cr1tbit/cyberlamp/outline.dxf

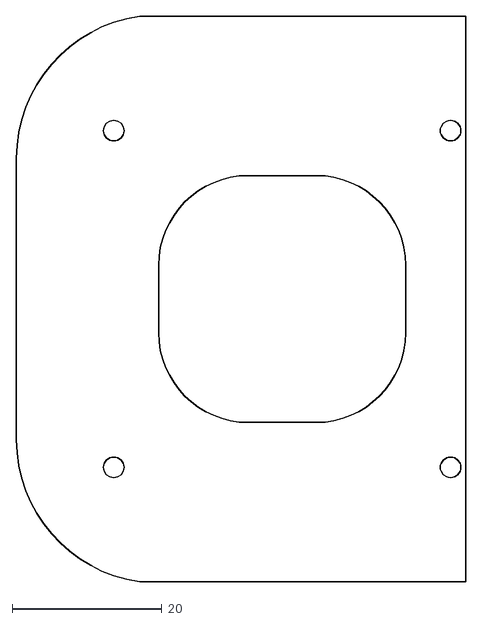
[picture p2: CAD file, 2026-11-09]
outline.dxf
60.0 x 75.6
