cr1tbit/cyberlamp/schematic.pdf

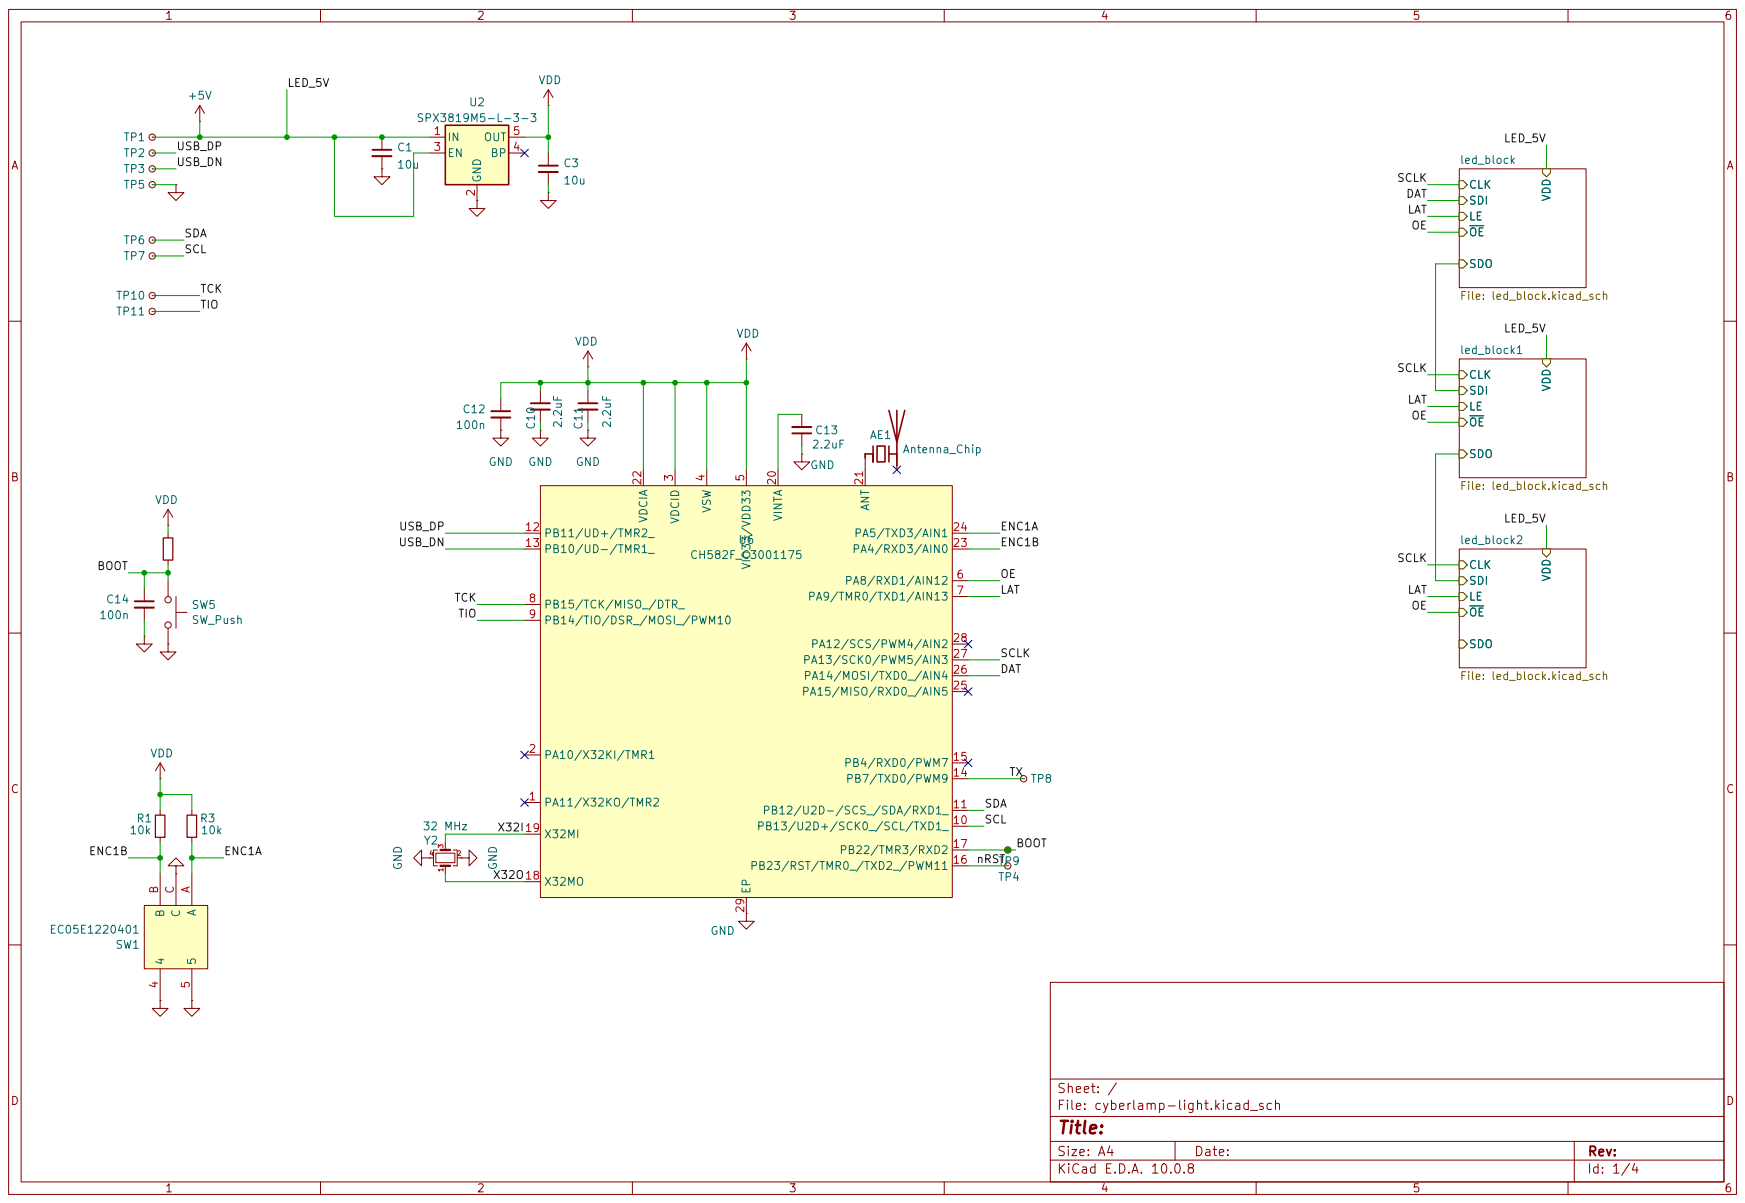
[picture p3: page 1]

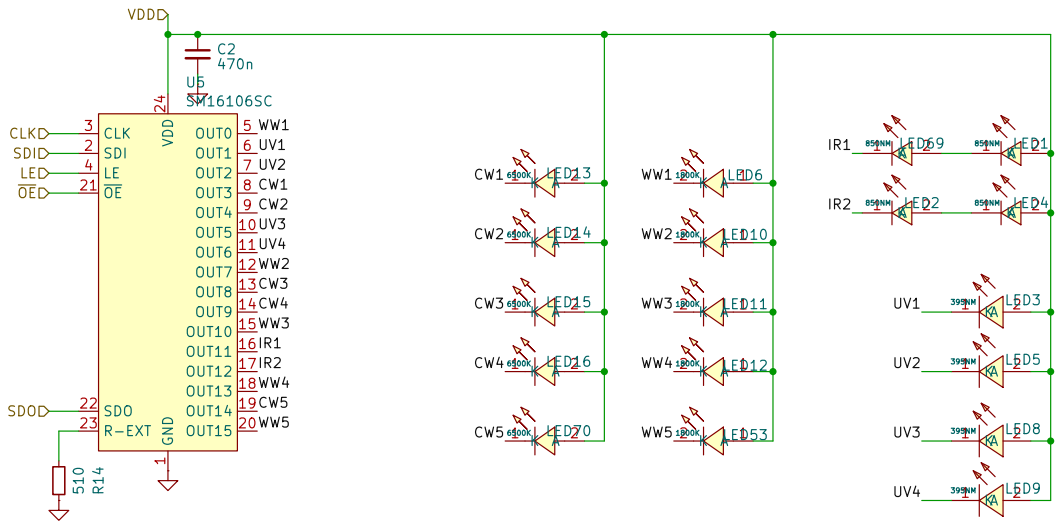
[picture p4: page 2]
