cr1tbit/cyberlamp/cyberlamp-light.kicad_pcb

## KiCad design cyberlamp-light.kicad_pcb (2026-11-09)

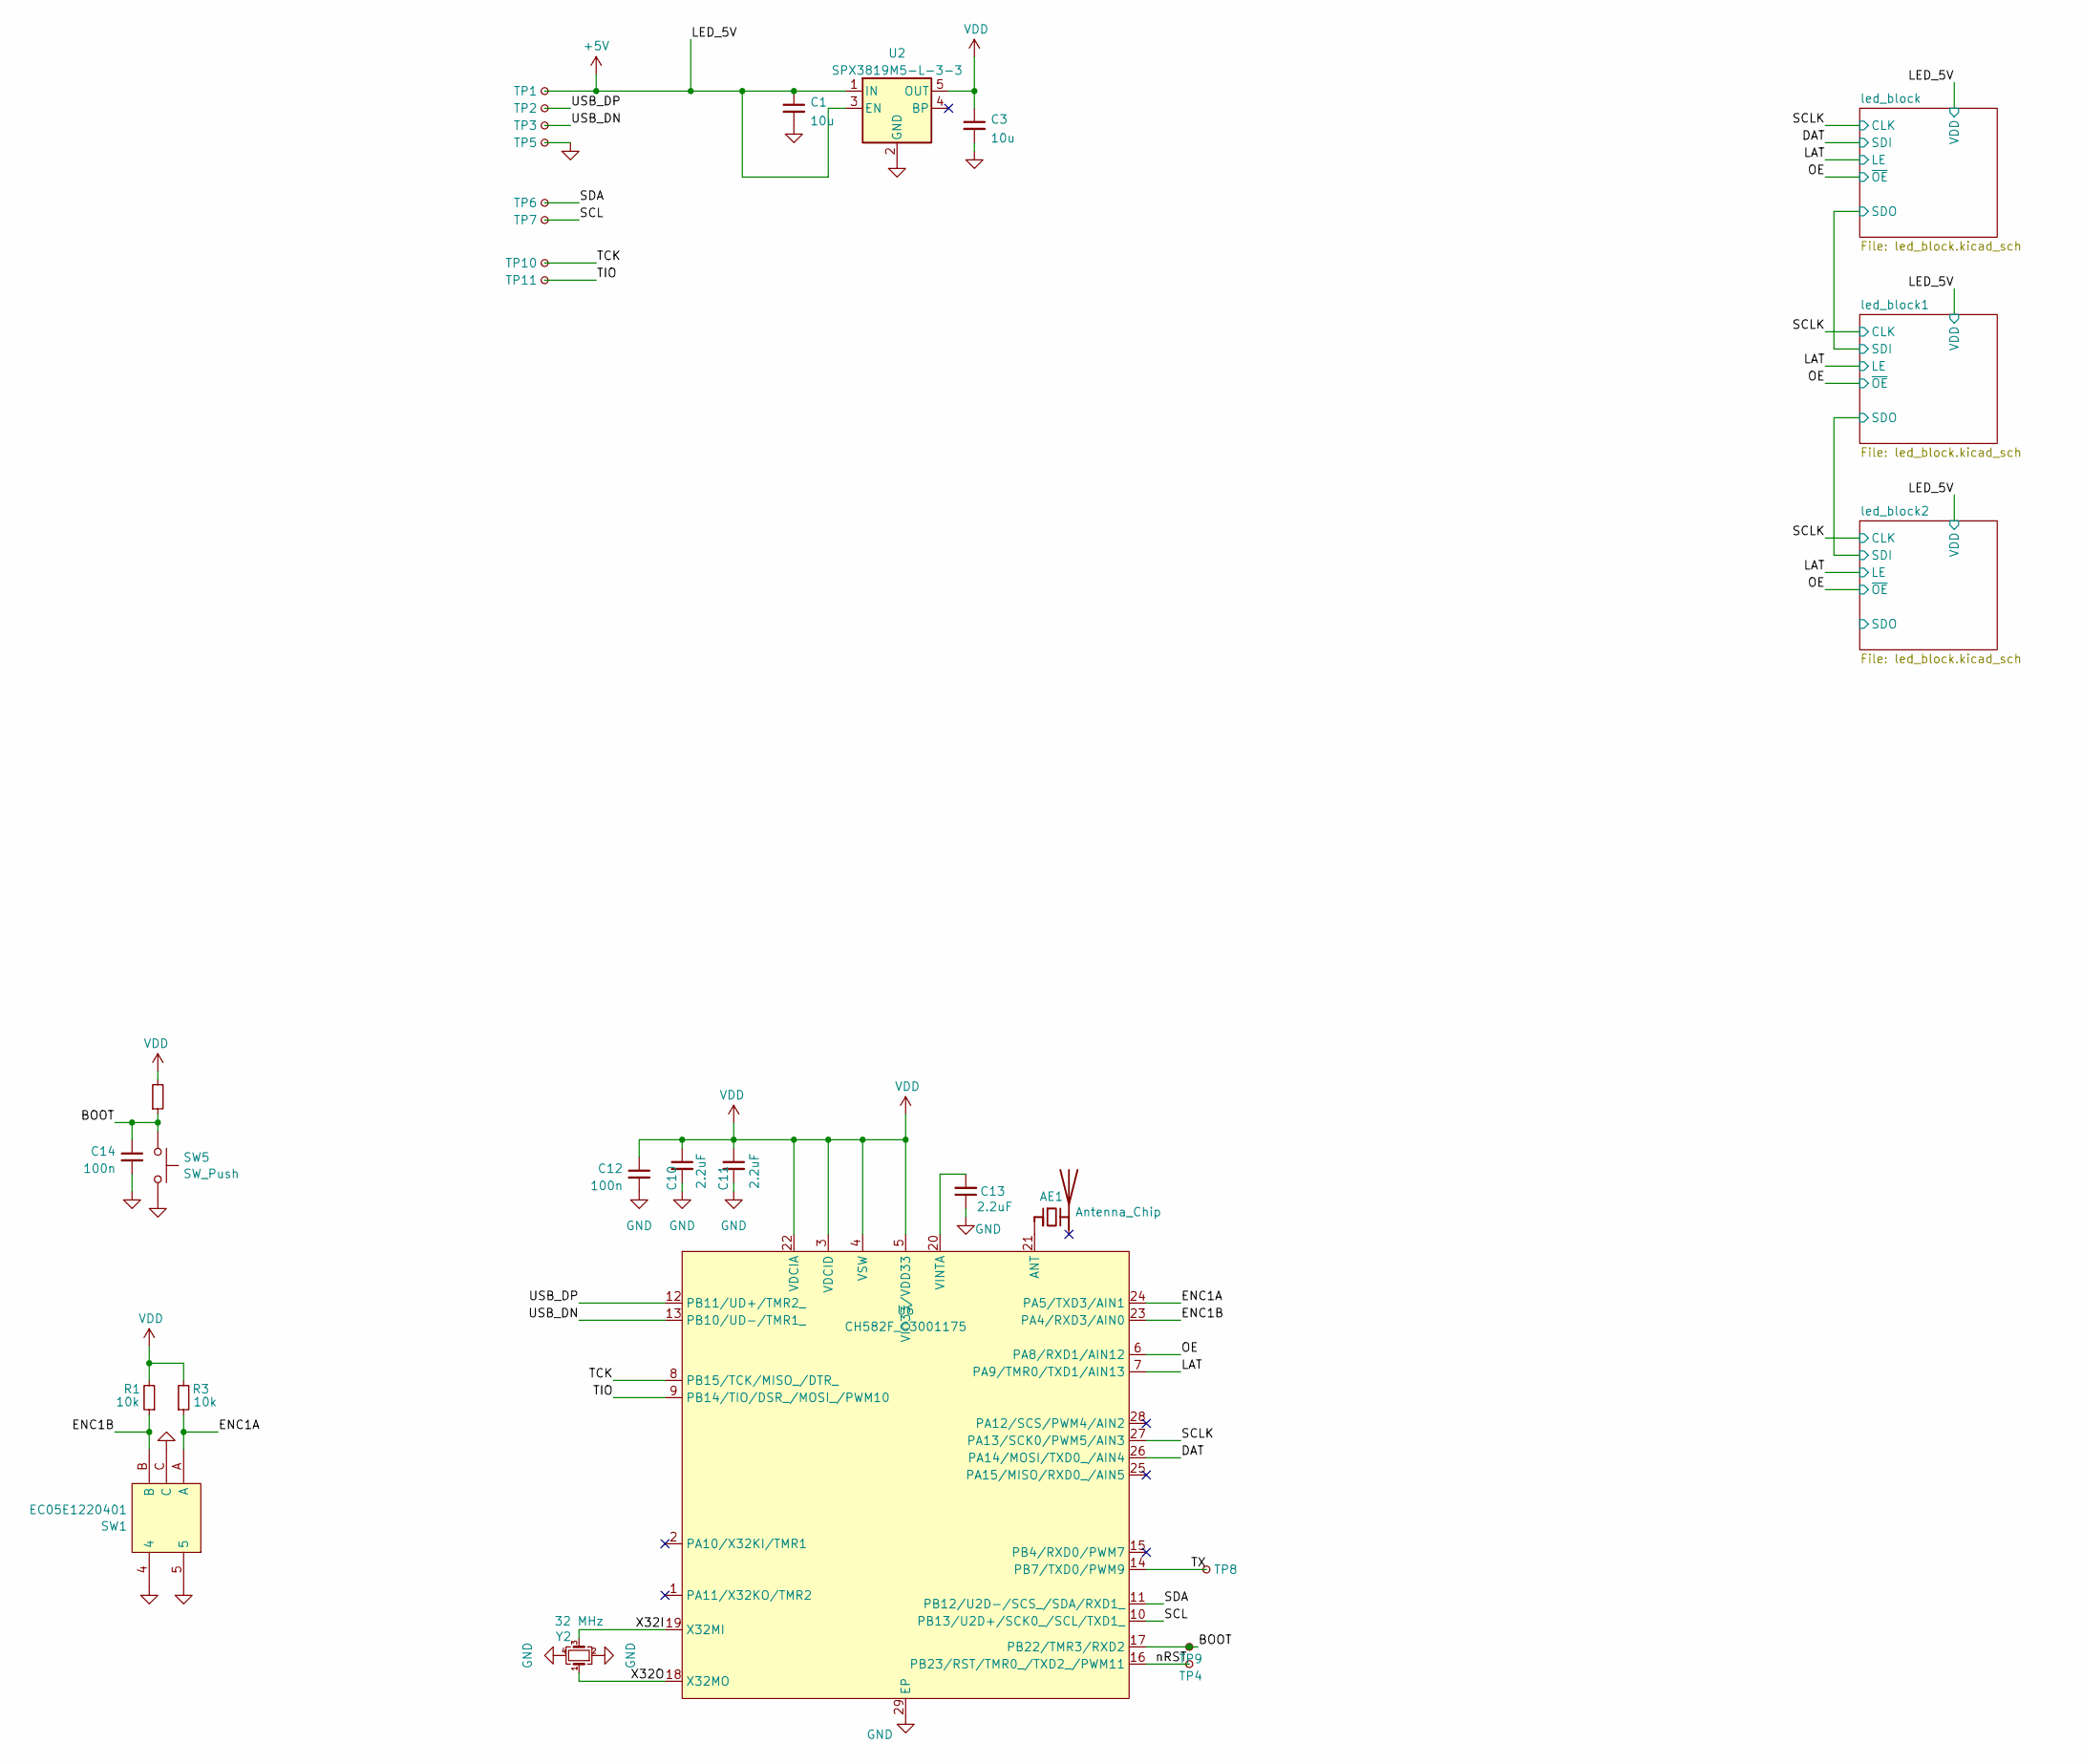
[picture p5: schematic cyberlamp-light.kicad_sch]

Parts:
AE1: Antenna_Chip; Johanson_2450AT18x100; LCSC C127629
C1, C3: 10u; C_0603_1608Metric; LCSC C96446
C10, C11, C13: 2.2uF; C_0402_1005Metric; LCSC C12530
C12, C14: 100n; C_0402_1005Metric; LCSC C307331
R1, R3, R13: 10k; R_0402_1005Metric; LCSC C25744
SW1: EC05E1220401; SW-SMD_EC05E1220401; LCSC C116648
SW5: SW_Push; SW_PUSH_6mm_H5mm
TP1, TP2, TP3, TP4, TP5, TP6, TP7, TP8, TP9, TP10, TP11: RX; TestPoint_Pad_D1.0mm
U2: SPX3819M5-L-3-3; SOT-23-5; LCSC C5370980
U6: CH582F_C3001175; QFN-28_L4.0-W4.0-P0.40-BL-EP2.8; LCSC C3001175
Y2: 32 MHz; Crystal_SMD_2016-4Pin_2.0x1.6mm; LCSC C2682773

Connections:
+5V: C1.1, TP1.1 (1_1), U2.1 (IN), U2.3 (EN); also elsewhere on the board
/BOOT: C14.1, R13.1, SW5.1, TP9.1 (1_1), U6.17 (PB22/TMR3/RXD2)
/DAT: U6.26 (PA14/MOSI/TXD0_/AIN4); also elsewhere on the board
/ENC1A: R3.1, SW1.A, U6.24 (PA5/TXD3/AIN1)
/ENC1B: R1.1, SW1.B, U6.23 (PA4/RXD3/AIN0)
/LAT: U6.7 (PA9/TMR0/TXD1/AIN13); also elsewhere on the board
/OE: U6.6 (PA8/RXD1/AIN12); also elsewhere on the board
/SCL: TP7.1 (1_1), U6.10 (PB13/U2D+/SCK0_/SCL/TXD1_)
/SCLK: U6.27 (PA13/SCK0/PWM5/AIN3); also elsewhere on the board
/SDA: TP6.1 (1_1), U6.11 (PB12/U2D-/SCS_/SDA/RXD1_)
/TCK: TP10.1 (1_1), U6.8 (PB15/TCK/MISO_/DTR_)
/TIO: TP11.1 (1_1), U6.9 (PB14/TIO/DSR_/MOSI_/PWM10)
/TX: TP8.1 (1_1), U6.14 (PB7/TXD0/PWM9)
/USB_DN: TP3.1 (1_1), U6.13 (PB10/UD-/TMR1_)
/USB_DP: TP2.1 (1_1), U6.12 (PB11/UD+/TMR2_)
/X32I: U6.19 (X32MI), Y2.3
/X32O: U6.18 (X32MO), Y2.1
/nRST: TP4.1 (1_1), U6.16 (PB23/RST/TMR0_/TXD2_/PWM11)
GND: C1.2, C3.2, C10.2, C11.2, C12.2, C13.1, C14.2, SW1.4, SW1.5, SW1.C, SW5.2, TP5.1 (1_1), U2.2 (GND), U6.29 (EP), Y2.2, Y2.4; also elsewhere on the board
unnamed: AE1.1 (FEED_1), U6.21 (ANT)
unnamed: C13.2, U6.20 (VINTA)
VDD: C3.1, C10.1, C11.1, C12.1, R1.2, R3.2, R13.2, U2.5 (OUT), U6.3 (VDCID), U6.4 (VSW), U6.5 (VIO33/VDD33), U6.22 (VDCIA)

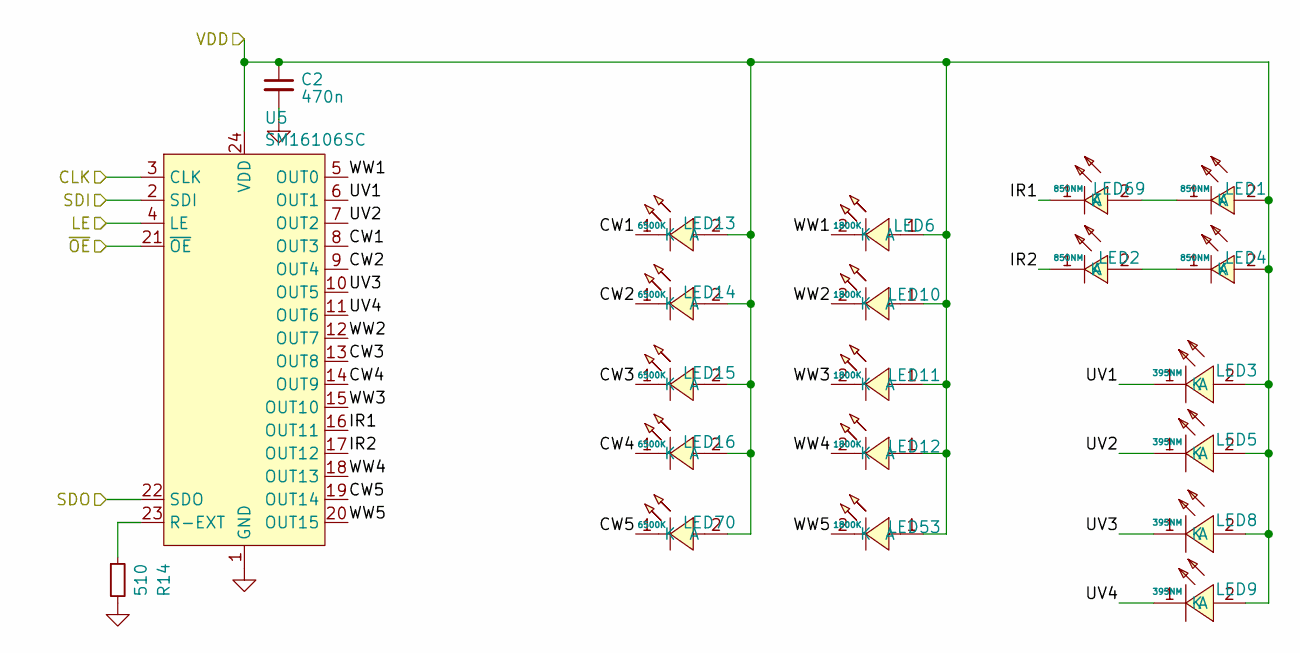
[picture p6: schematic led_block.kicad_sch]

Parts:
C2: 470n; C_0402_1005Metric; LCSC C52923
LED1, LED2, LED4, LED69: 850NM; LED-SMD_L3.5-W2.8_C9900017434; LCSC C5221242
LED3, LED5, LED8, LED9: 395NM; LED-SMD_L3.5-W2.8-RD_PURPLE; LCSC C2827317
LED6, LED10, LED11, LED12, LED53: 1800K; LED-SMD_L3.5-W2.8-R-RD_TJ-S2835UG5W8TLC6B-A5; LCSC C7371920
LED13, LED14, LED15, LED16, LED70: 6500K; LED-SMD_L3.5-W2.8-FD-2835_WHITE; LCSC C7423447
R14: 510; R_0402_1005Metric; LCSC C25123
U5: SM16106SC; QSOP-24_L8.7-W4.0-P0.64-LS6.0-BL; LCSC C121618

Connections:
+5V: C2.1, LED1.2 (A), LED3.2 (A), LED4.2 (A), LED5.2 (A), LED6.1 (A), LED8.2 (A), LED9.2 (A), LED10.1 (A), LED11.1 (A), LED12.1 (A), LED13.2 (A), LED14.2 (A), LED15.2 (A), LED16.2 (A), LED53.1 (A), LED70.2 (A), U5.24 (VDD); also elsewhere on the board
/DAT: U5.2 (SDI); also elsewhere on the board
/LAT: U5.4 (LE); also elsewhere on the board
/OE: U5.21 (~OE); also elsewhere on the board
/SCLK: U5.3 (CLK); also elsewhere on the board
/led_block/CW1: LED13.1 (K), U5.8 (OUT3)
/led_block/CW2: LED14.1 (K), U5.9 (OUT4)
/led_block/CW3: LED15.1 (K), U5.13 (OUT8)
/led_block/CW4: LED16.1 (K), U5.14 (OUT9)
/led_block/CW5: LED70.1 (K), U5.19 (OUT14)
/led_block/IR1: LED69.1 (K), U5.16 (OUT11)
/led_block/IR2: LED2.1 (K), U5.17 (OUT12)
/led_block/SDO: U5.22 (SDO); also elsewhere on the board
/led_block/UV1: LED3.1 (K), U5.6 (OUT1)
/led_block/UV2: LED5.1 (K), U5.7 (OUT2)
/led_block/UV3: LED8.1 (K), U5.10 (OUT5)
/led_block/UV4: LED9.1 (K), U5.11 (OUT6)
/led_block/WW1: LED6.2 (K), U5.5 (OUT0)
/led_block/WW2: LED10.2 (K), U5.12 (OUT7)
/led_block/WW3: LED11.2 (K), U5.15 (OUT10)
/led_block/WW4: LED12.2 (K), U5.18 (OUT13)
/led_block/WW5: LED53.2 (K), U5.20 (OUT15)
GND: C2.2, R14.2, U5.1 (GND); also elsewhere on the board
unnamed: LED1.1 (K), LED69.2 (A)
unnamed: LED2.2 (A), LED4.1 (K)
unnamed: R14.1, U5.23 (R-EXT)

Parts of its further copies:
C7, C8: 470n; C_0402_1005Metric; LCSC C52923
LED17, LED18, LED20, LED21, LED35, LED36, LED38, LED39: 850NM; LED-SMD_L3.5-W2.8_C9900017434; LCSC C5221242
LED19, LED22, LED24, LED27, LED30, LED37, LED40, LED42, LED45, LED48: 6500K; LED-SMD_L3.5-W2.8-FD-2835_WHITE; LCSC C7423447
LED23, LED26, LED29, LED32, LED41, LED44, LED47, LED50: 395NM; LED-SMD_L3.5-W2.8-RD_PURPLE; LCSC C2827317
LED25, LED28, LED31, LED34, LED43, LED46, LED49, LED52, LED54, LED55: 1800K; LED-SMD_L3.5-W2.8-R-RD_TJ-S2835UG5W8TLC6B-A5; LCSC C7371920
R4, R5: 510; R_0402_1005Metric; LCSC C25123
U1, U3: SM16106SC; QSOP-24_L8.7-W4.0-P0.64-LS6.0-BL; LCSC C121618

Connections of its further copies:
+5V: C7.1, C8.1, LED18.2 (A), LED19.2 (A), LED21.2 (A), LED22.2 (A), LED23.2 (A), LED24.2 (A), LED25.1 (A), LED26.2 (A), LED27.2 (A), LED28.1 (A), LED29.2 (A), LED30.2 (A), LED31.1 (A), LED32.2 (A), LED34.1 (A), LED36.2 (A), LED37.2 (A), LED39.2 (A), LED40.2 (A), LED41.2 (A), LED42.2 (A), LED43.1 (A), LED44.2 (A), LED45.2 (A), LED46.1 (A), LED47.2 (A), LED48.2 (A), LED49.1 (A), LED50.2 (A), LED52.1 (A), LED54.1 (A), LED55.1 (A), U1.24 (VDD), U3.24 (VDD); also elsewhere on the board
/LAT: U1.4 (LE), U3.4 (LE); also elsewhere on the board
/OE: U1.21 (~OE), U3.21 (~OE); also elsewhere on the board
/SCLK: U1.3 (CLK), U3.3 (CLK); also elsewhere on the board
/led_block1/CW1: LED19.1 (K), U1.8 (OUT3)
/led_block1/CW2: LED22.1 (K), U1.9 (OUT4)
/led_block1/CW3: LED24.1 (K), U1.13 (OUT8)
/led_block1/CW4: LED27.1 (K), U1.14 (OUT9)
/led_block1/CW5: LED30.1 (K), U1.19 (OUT14)
/led_block1/IR1: LED17.1 (K), U1.16 (OUT11)
/led_block1/IR2: LED20.1 (K), U1.17 (OUT12)
/led_block1/SDO: U1.22 (SDO), U3.2 (SDI)
/led_block1/UV1: LED23.1 (K), U1.6 (OUT1)
/led_block1/UV2: LED26.1 (K), U1.7 (OUT2)
/led_block1/UV3: LED29.1 (K), U1.10 (OUT5)
/led_block1/UV4: LED32.1 (K), U1.11 (OUT6)
/led_block1/WW1: LED25.2 (K), U1.5 (OUT0)
/led_block1/WW2: LED28.2 (K), U1.12 (OUT7)
/led_block1/WW3: LED31.2 (K), U1.15 (OUT10)
/led_block1/WW4: LED34.2 (K), U1.18 (OUT13)
/led_block1/WW5: LED54.2 (K), U1.20 (OUT15)
/led_block2/CW1: LED37.1 (K), U3.8 (OUT3)
/led_block2/CW2: LED40.1 (K), U3.9 (OUT4)
/led_block2/CW3: LED42.1 (K), U3.13 (OUT8)
/led_block2/CW4: LED45.1 (K), U3.14 (OUT9)
/led_block2/CW5: LED48.1 (K), U3.19 (OUT14)
/led_block2/IR1: LED35.1 (K), U3.16 (OUT11)
/led_block2/IR2: LED38.1 (K), U3.17 (OUT12)
/led_block2/SDO: U3.22 (SDO)
/led_block2/UV1: LED41.1 (K), U3.6 (OUT1)
/led_block2/UV2: LED44.1 (K), U3.7 (OUT2)
/led_block2/UV3: LED47.1 (K), U3.10 (OUT5)
/led_block2/UV4: LED50.1 (K), U3.11 (OUT6)
/led_block2/WW1: LED43.2 (K), U3.5 (OUT0)
/led_block2/WW2: LED46.2 (K), U3.12 (OUT7)
/led_block2/WW3: LED49.2 (K), U3.15 (OUT10)
/led_block2/WW4: LED52.2 (K), U3.18 (OUT13)
/led_block2/WW5: LED55.2 (K), U3.20 (OUT15)
/led_block/SDO: U1.2 (SDI); also elsewhere on the board
GND: C7.2, C8.2, R4.2, R5.2, U1.1 (GND), U3.1 (GND); also elsewhere on the board
unnamed: LED17.2 (A), LED18.1 (K)
unnamed: LED20.2 (A), LED21.1 (K)
unnamed: LED35.2 (A), LED36.1 (K)
unnamed: LED38.2 (A), LED39.1 (K)
unnamed: R4.1, U1.23 (R-EXT)
unnamed: R5.1, U3.23 (R-EXT)

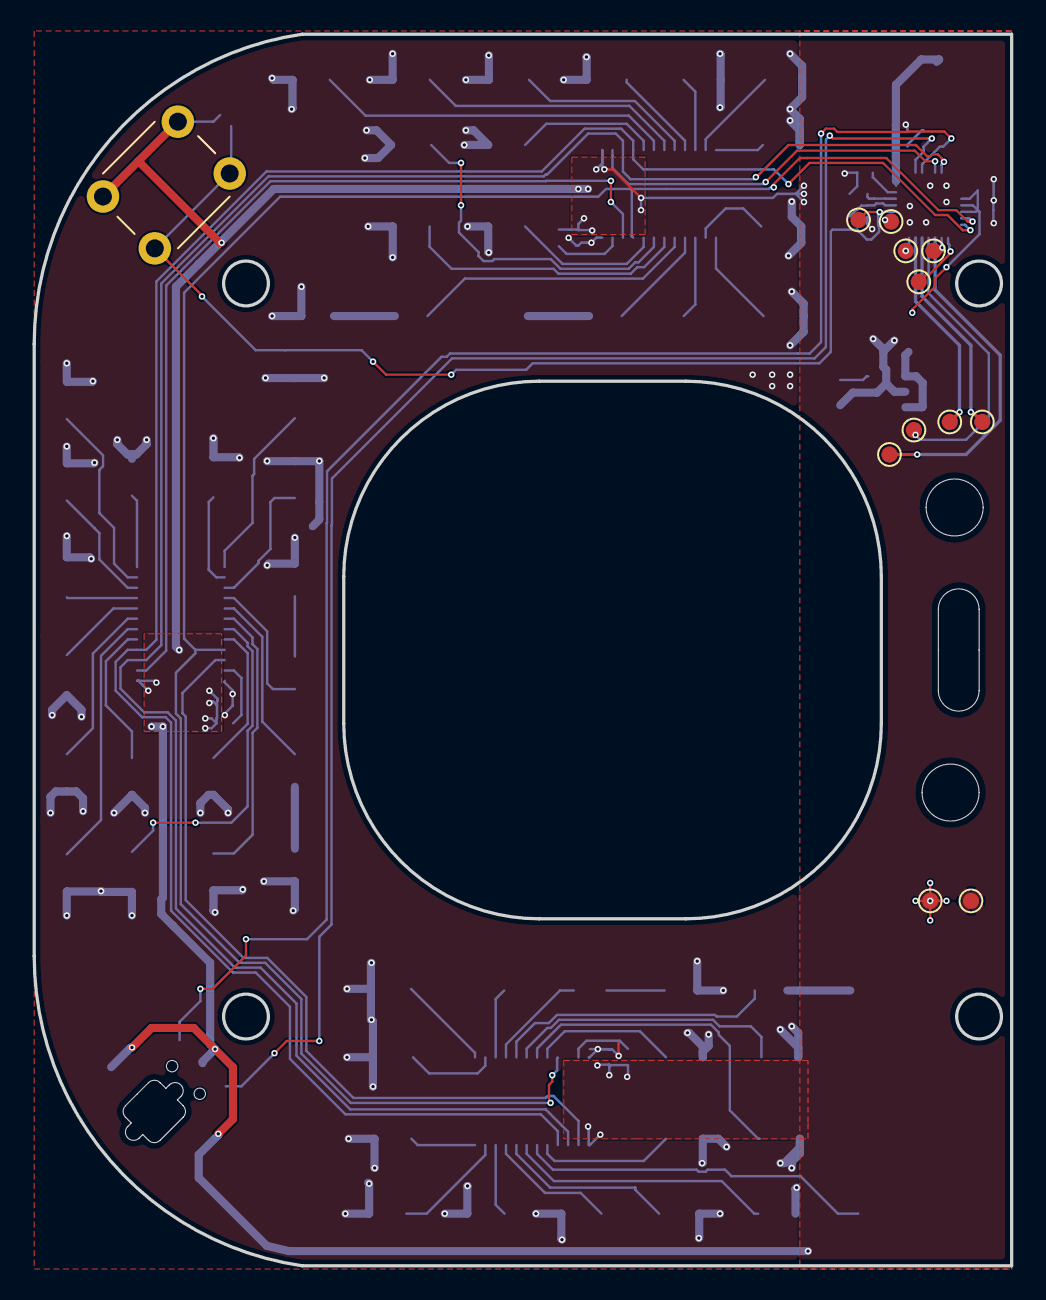
[picture p7: board cyberlamp-light.kicad_pcb from above]

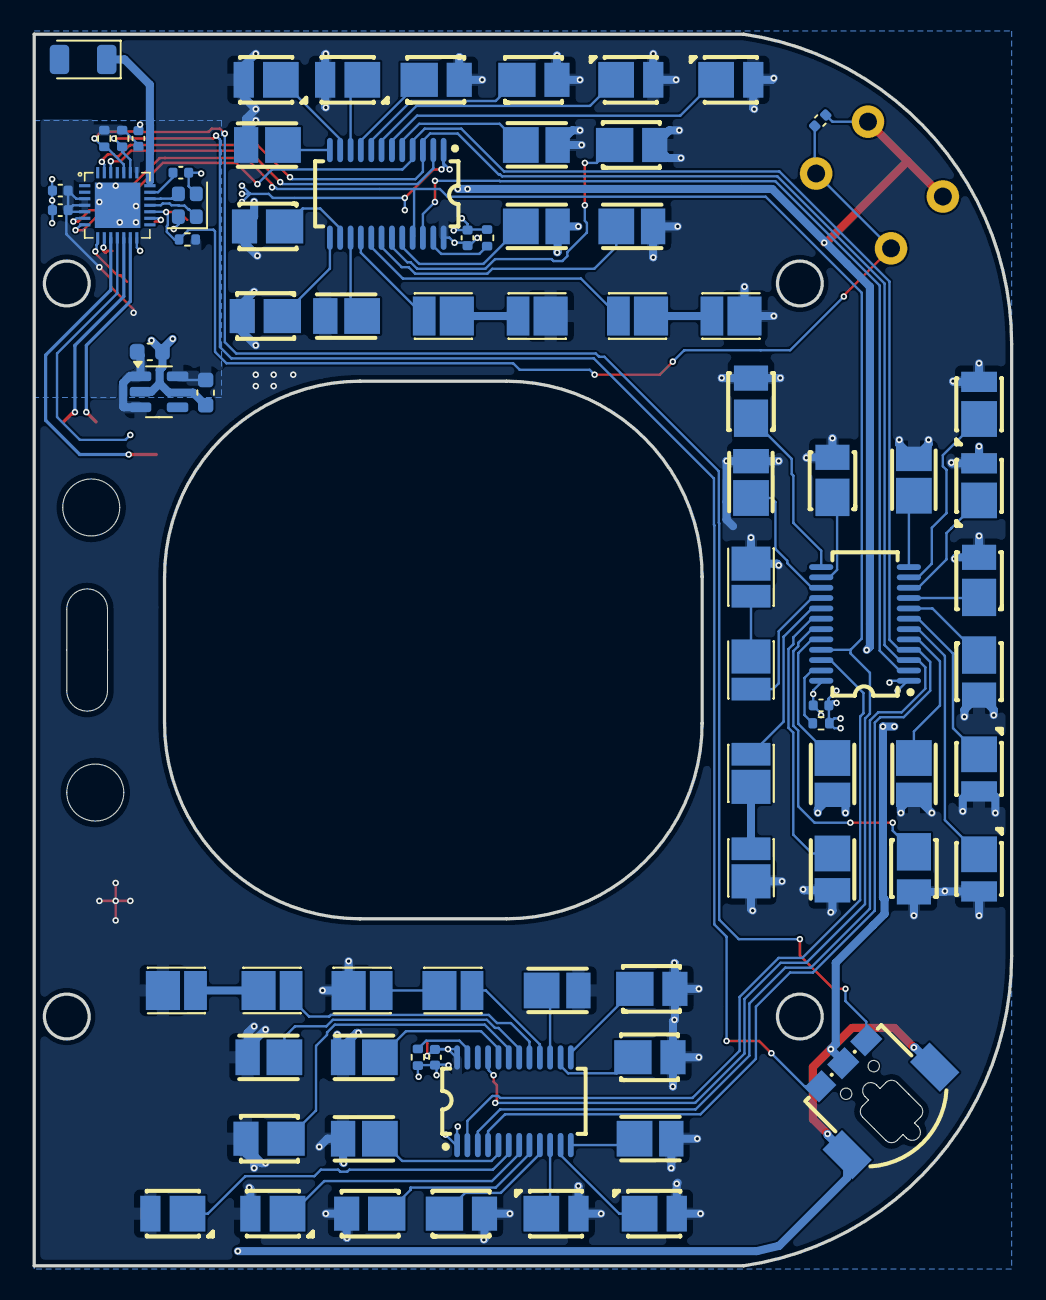
[picture p8: board cyberlamp-light.kicad_pcb from below]

Board: 2 copper layers, 60.0 x 75.6 mm, 90 parts (78 on the bottom side), 81 nets.
