cr1tbit/cyberlamp/(commit log)

2026-11-09 readme, schematic pdf
    [cyberlamp-light.kicad_sch]
2026-11-12 rename BLE device, add actions with control page
2026-11-13 firmware: use hal::embassy::Executor; bump ch58x-hal and kit together
    - The HAL's executor replaces embassy's arch-riscv32 one (and the continuous
    polling): it sleeps in WFE without losing wake-ups.
    - ch58x-hal fd6e463: the BLE stack (TMOS) runs only when it has work instead
    of every 300 us - noticeably less software-PWM flicker.
    - kit de75106 together with it: older kits define their own RTC interrupt
    handler, which now clashes with the HAL's.
    Tested on the lamp: NUS console, 10 min held connection (84/84), broadcast +
    NUS combo test (cyberlamp_fw_adv).
    [cyberlamp_fw.rs, cyberlamp_fw_adv.rs, cyberlamp_fw_simple.rs]
